alasulu/SAPA-ECG-Respitory-MATLAB-App/(list of files, cad)

Other CAD files:
SAPA_Project_Box.f3d
