alasulu/SAPA-ECG-Respitory-MATLAB-App/(list of files, drawings)

Other design files:
PCB2.PcbDoc
PCB_Sheet1.SchDoc
